nagars/DigitalStethoscope/Media/IMG20210109195346.jpg

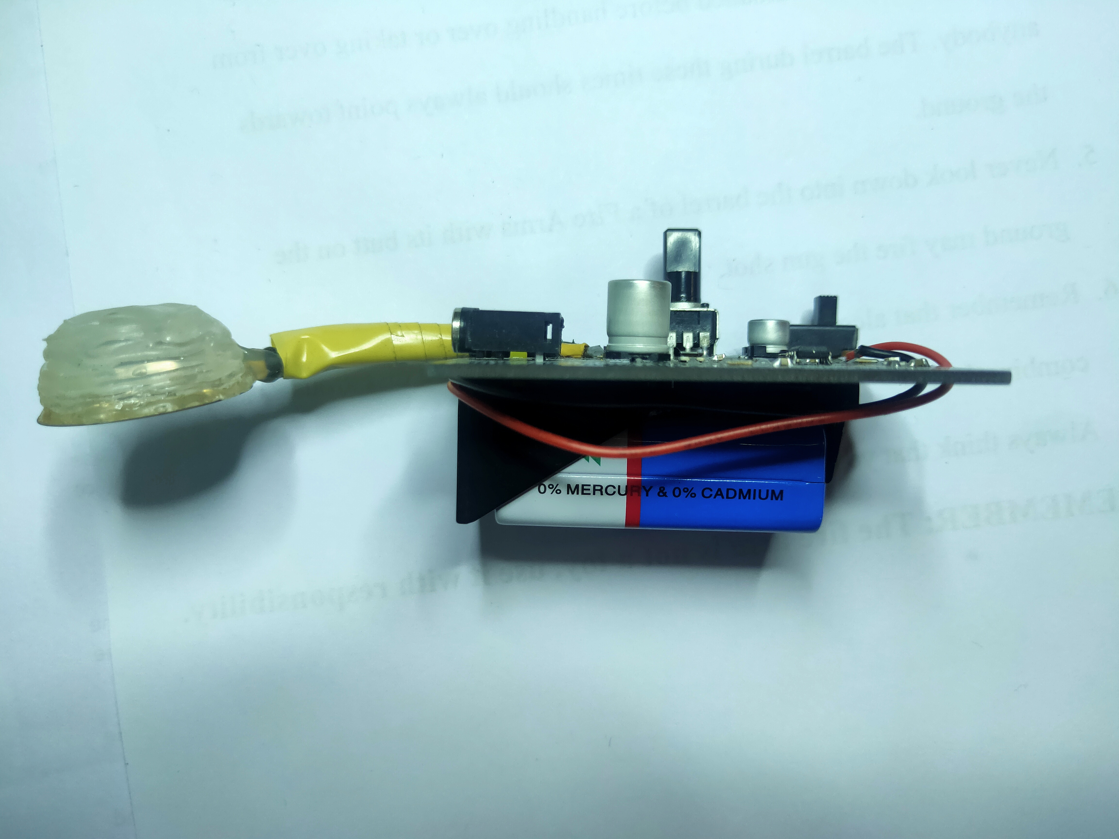
Media/IMG20210109195346.jpg
