nagars/DigitalStethoscope/Media/IMG20210109204416.jpg

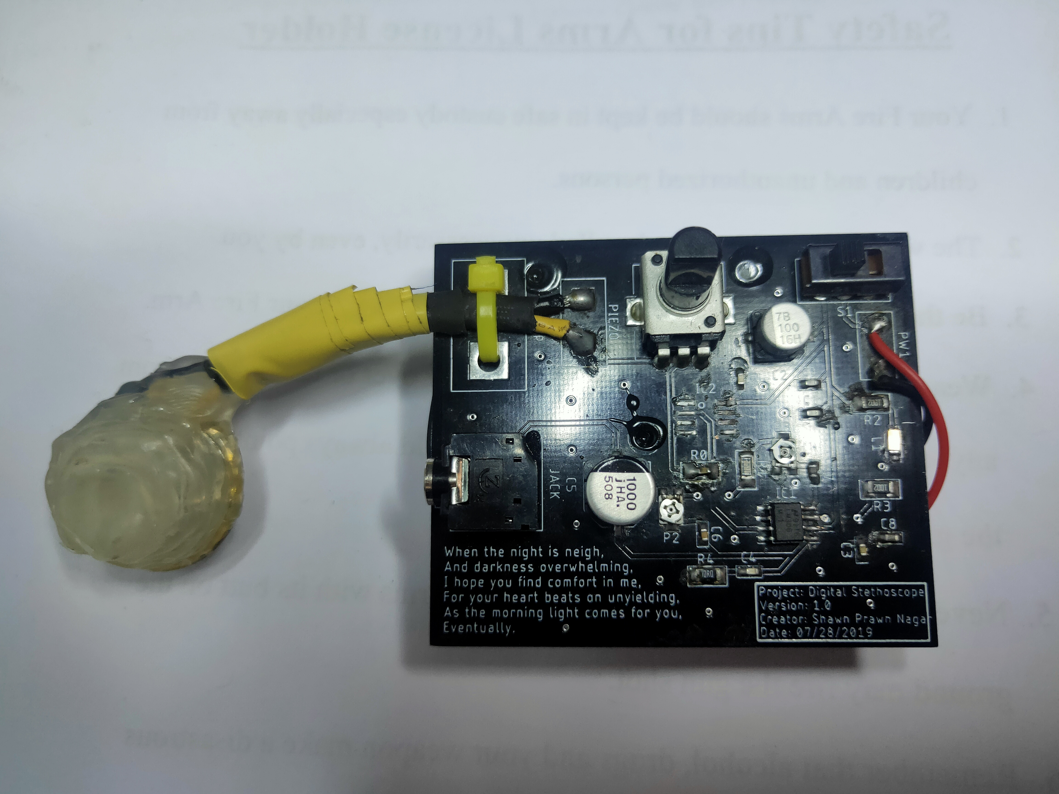
Media/IMG20210109204416.jpg
