nagars/DigitalStethoscope/BOM.xlsx

Qty | Value | Device | Package | Parts
1 | 1000uF | Electrolytic Capacitor |  | C5 | https://www.arrow.com/en/products/eee-ha0j102up/panasonic?q=EEE-HA0J102UP
1 | 100uF | Electrolytic Capacitor |  | C4 | https://www.arrow.com/en/products/vzh101m1ctr-0606/lelon-electronics?q=VZH101M1CTR-0606
3 | 0.1uF | Ceramic Capacitor | C0603K | C2, C3, C9
2 | 10uF | Ceramic Capacitor | C0603K | C7, C8
1 | 33nF | Ceramic Capacitor | C0603K | C6
1 | 470pF | Ceramic Capacitor | C0603K | C0
1 | 10 ohm | Resistor | C1206K | R4
1 | 0 ohm | Resistor | C1206K | R0
1 | 10K ohm | Resistor | C1206K | R3
1 | 2.2K ohm | Resistor | C1206K | R1
1 | 75 ohm | Resistor | C1206K | R2
1 | 10K ohm | Potentiometer Rear Mounted - PTV09A-4220F-B103 |  | P1 | https://www.arrow.com/en/products/ptv09a-4220f-b103/bourns?q=PTV09A-4220F-B103
1 | 10K ohm | Potentiometer - TC33X-1/2 |  | P2 | https://www.arrow.com/en/products/tc33x-1-103e/bourns?q=TC33X-1-103E
1 | 5K ohm | Potentiometer - TC33X-2 |  | P3 | https://www.arrow.com/en/products/tc33x-2-502e/bourns?q=TC33X-2-502E
1 |  | SPDT Switch | 9450-1 | S1
1 |  | CLAMP |  | U1
1 |  | 3.5 mm JACK |  | J1
1 |  | LED |  | L1 | https://www.arrow.com/en/products/ltw-k140szr65-eu/lite-on-technology
1 |  | LM158DTD | SO08 | IC2 | https://www.arrow.com/en/products/lm158dt/stmicroelectronics?q=LM158DT
1 |  | LM386MX-11M | SO08 | IC1 | https://www.arrow.com/en/products/lm386mx-1nopb/texas-instruments?q=LM386MX-1%2FNOPB
1 |  | Piezo Sensor |  |  | https://www.amazon.in/OLatus-OL-SENSOR-PIEZO-DISC-Piezoelectric-Sensor-Transducer/dp/B075VYNP3F
1 |  | 9V Battery Holder |  |  | https://www.arrow.com/en/products/hh-3635/bud-industries?q=HH-3635
