nagars/DigitalStethoscope/Eagle/Dig_Stethoscope/Dig_Stethoscope.brd

## EAGLE design Eagle/Dig_Stethoscope/Dig_Stethoscope.brd (2019-06-25)

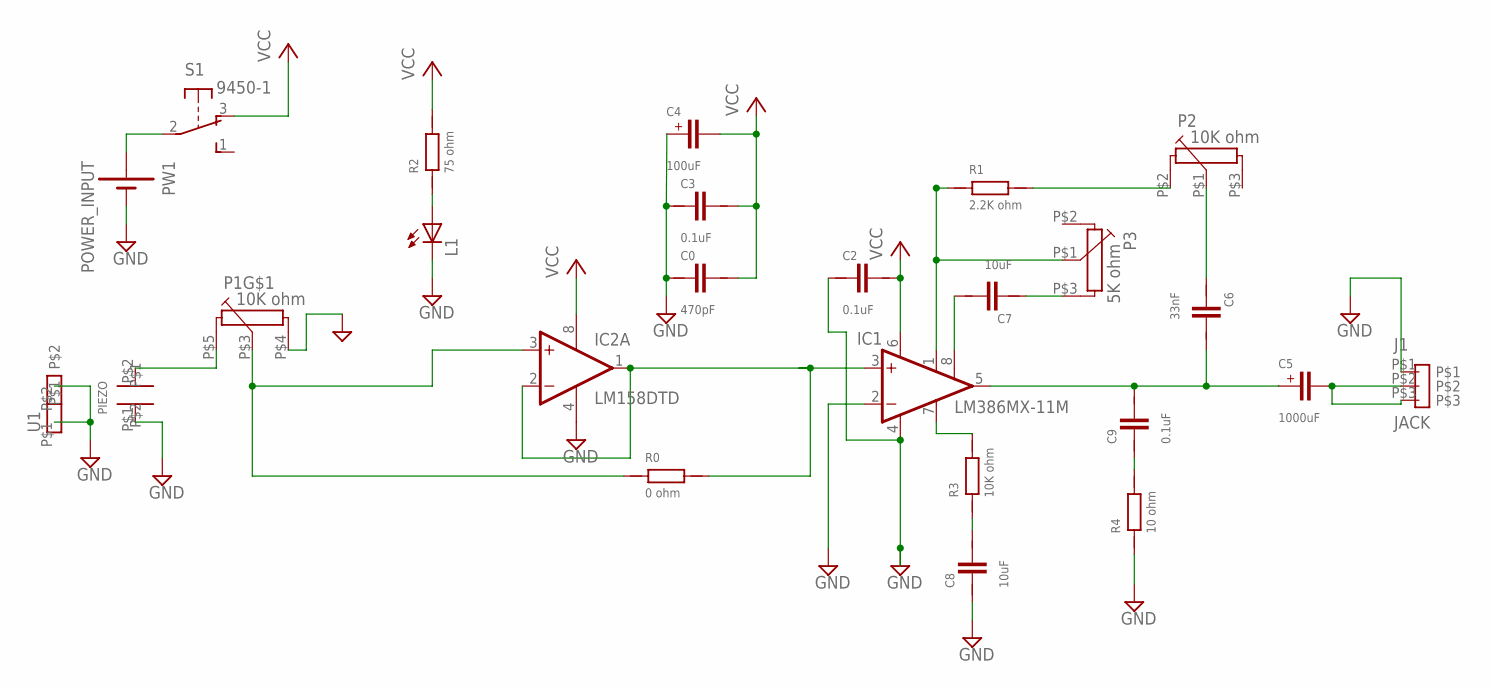
[picture p3: schematic Dig_Stethoscope.sch]

Parts:
C0: 470pF; C0603K
C2, C3, C9: 0.1uF; C0603K
C4: 100uF; CAP_100UF
C5: 1000uF; CAP_1000F
C6: 33nF; C0603K
C7, C8: 10uF; C0603K
IC1: LM386MX-11M; SO08
IC2: LM158DTD; SO08
J1: JACK
L1: L140_LED; LTW_LED
P1: 10K ohm; DIP_POT
P2: 10K ohm; TC33X-1/2
P3: 5K ohm; TC33X-1/2
PIEZO: PIEZO_INPUT; 2_PIEZO_DIP
PW1: POWER_INPUT; 2_POWER_DIP
R0: 0 ohm; C1206K
R1: 2.2K ohm; C1206K
R2: 75 ohm; C1206K
R3: 10K ohm; C1206K
R4: 10 ohm; C1206K
S1: 9450-1
U1: CLAMP

Connections:
GND: C0.1, C2.1, C3.1, C4.P$2 (1), C8.1, IC1.2 (-IN), IC1.4 (GND), IC2.4 (V-), J1.P$1, L1.CATH_2 (C), P1.P$1 (GND), P1.P$2 (GND), P1.P$4 (1E), PIEZO.P$1, PW1.P$2 (-), R4.1, U1.P$1, U1.P$2
unnamed: IC2.3 (+IN), P1.P$3 (1S), R0.1
unnamed: P1.P$5 (1A), PIEZO.P$2
unnamed: IC1.3 (+IN), IC2.1 (OUT), IC2.2 (-IN), R0.2
unnamed: C5.P$2 (1), C6.2, C9.2, IC1.5 (OUT)
unnamed: IC1.1 (GAIN), P3.P$1 (1S), R1.1
unnamed: P2.P$2 (1A), R1.2
unnamed: C6.1, P2.P$1 (1S)
unnamed: C7.1, P3.P$3 (1E)
unnamed: C7.2, IC1.8 (GAIN)
unnamed: L1.ANODE_1 (A), R2.1
unnamed: IC1.7 (BYPASS), R3.2
unnamed: C8.2, R3.1
unnamed: C9.1, R4.2
unnamed: PW1.P$1 (+), S1.2
unnamed: C5.P$1 (2), J1.P$2, J1.P$3
VCC: C0.2, C2.2, C3.2, C4.P$1 (2), IC1.6 (VS), IC2.8 (V+), R2.2, S1.3 (O)

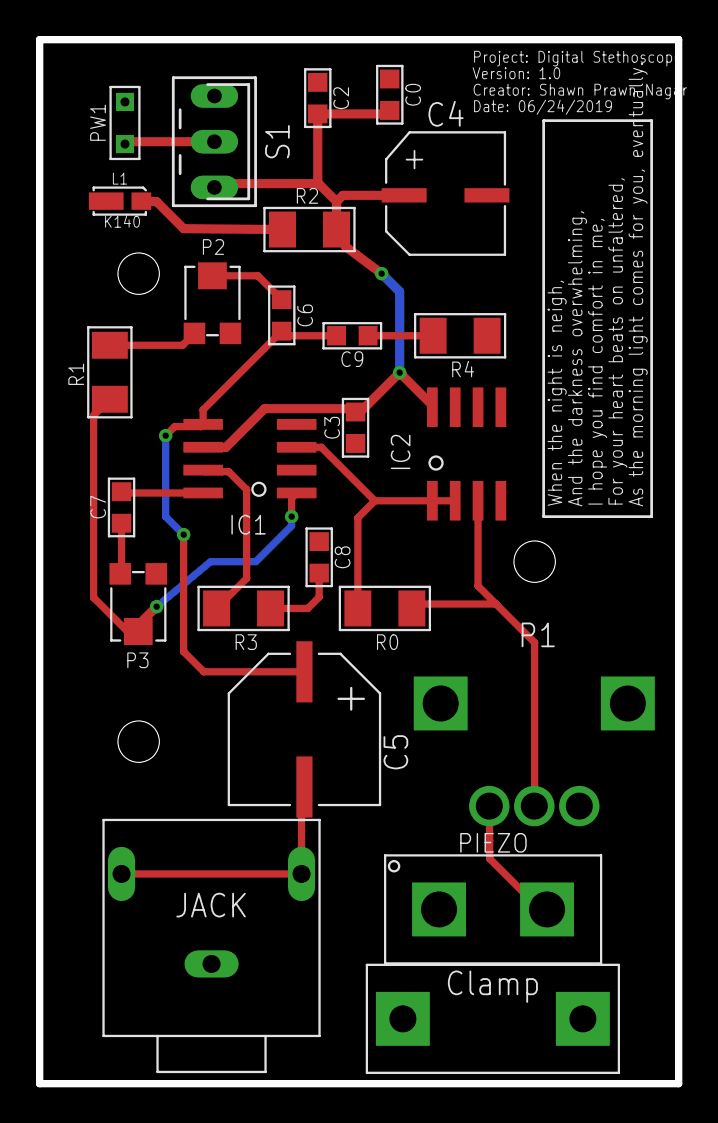
[picture p4: board Dig_Stethoscope.brd from above]

Board: 2 copper layers, 35.5 x 58.0 mm, 26 parts (0 on the bottom side), 17 nets.

Other parts of the board:
U$1: POWER_SOCKET
