nagars/DigitalStethoscope/(commit log)

2019-06-25 First Commit
    All essential datasheets. Current Circuit schematic/PCB layout. Text sizes on layout have to be increased to 2mm in all parts of my eagle part library. Board size needs to be increased to accommodate.
    [Dig_Stethoscope.brd, Dig_Stethoscope.sch, Dig_Stethoscope2.brd, Dig_Stethoscope2.sch, Dig_Stethoscope_final.brd, Dig_Stethoscope_final.sch]
2021-01-09 Added a BOM and pictures of the first functional device
    [BOM.xlsx, Dig_Stethoscope.brd, Dig_Stethoscope.sch, Dig_Stethoscope2.brd, Dig_Stethoscope2.sch]
